nutshell114514/TU-Smart2026/(list of files, drawings)

Other design files:
硬件/21届智能车+蚂蚁搬家+主驱一体PCB文件.epro
