nutshell114514/TU-Smart2026/软件/比赛代码/下位机/config.py

# 整车任务的集中配置。除车辆身份外，主从车应使用相同参数。


# =============================================================================
# 车辆身份与位姿
# =============================================================================

# 1 = 主车，0 = 从车。build.bat 会为主从车生成对应配置。
_IS_LEADER = 1

# 上电时写入底层里程计的初始位置，单位为 cm；主从初始航向已固定在 base.py。
_LEADER_INIT_POS = (40.0, -40.0)
_FOLLOWER_INIT_POS = (10.0, -40.0)

# DONE 状态中主车、从车各自返回的世界坐标目标点，单位为 cm。
_DONE_TARGET_POS = (
    (25.0, -70.0),  # 主车
    (25.0, -70.0),  # 从车
)


# =============================================================================
# 搬运任务数量
# =============================================================================

# 1 = 只知道物体总数，使用 _OBJ_UNKNOWN_TOTAL，不限制各类别出现次数。
# 2 = 已知类别组数量，使用 _OBJ_GROUPS / _OBJ_GROUP_TOTAL；同组颜色二选一。
# 3 = 已知五类物体各自数量，使用 _OBJ_CLASS_TOTAL；每一类必须分别完成，不能互相替代。
_OBJ_COUNT_MODE = 3

# 模式 3：五类物体各自需要成功推出的数量。
# 第 0 项保留不用；1=网球，2=蓝沙包，3=红沙包，4=白熊，5=棕熊。
# 数量为 0 的类别不会被选择；只有五类剩余数量全部归零才结束任务。
_OBJ_CLASS_TOTAL = (0, 1, 1, 0, 1, 0)

# 模式 2：类别组成员与每组需要完成的数量。
# 当前任务固定为网球、任一颜色沙包、任一颜色熊各 1 个，共 3 个目标。
_OBJ_GROUPS = (
    (1,),    # 网球
    (2, 3),  # 蓝沙包、红沙包二选一
    (4, 5),  # 白熊、棕熊二选一
)
# 每一个组的目标数量，索引与 _OBJ_GROUPS 对应。
_OBJ_GROUP_TOTAL = (1, 1, 0)

# 模式 1：全部可搬运物体的总数。
_OBJ_UNKNOWN_TOTAL = 3


# =============================================================================
# WAIT_READY 路线换阵列避障
# =============================================================================

# 0 = 关闭：不检查其他待搬物体是否挡路，双车就绪后直接进入正常 PUSH。
# 1 = 开启：挡路时先换阵列横向推开目标，再恢复阵列并正常 PUSH。
_READY_ROUTE_AVOID_ENABLE = 0


# =============================================================================
# SEARCH / PUSH 场边 cone、brick 布局过滤
# =============================================================================

# 0 = 关闭：保持旧逻辑，完全不知道场边布局，只相信视觉识别结果。
# 1 = 开启：只有布局表允许的 cone/brick 才能触发 SEARCH 或 PUSH 障碍逻辑。
_OBSTACLE_LAYOUT_FILTER_ENABLE = 1

# 物体编号：0 = 没有，1 = cone，2 = brick。
# 每条边填 3 个位置；同一个位置只能填一个编号。
# 边顺序固定为 1、2、3、4，对应关系见 task_leader.py 的 _OBJ_PUSH_EDGE：
#   边1（高 Y，网球边）按 X 从小到大；边2（低 X，沙包边）按 Y 从小到大；
#   边3（高 X，熊边）按 Y 从小到大；边4（低 Y，无固定推送目标的边）按 X 从小到大。
# 目前先全部留空；填好现场布局后，再把上面的总开关改成 1。
_OBSTACLE_EDGE_LAYOUT = (
    (0, 0, 0),  # 边1（网球边）：X 小、中、大
    (0, 0, 2),  # 边2（沙包边）：Y 小、中、大
    (0, 0, 0),  # 边3（熊边）：Y 小、中、大
    (0, 0, 0),  # 边4（无固定推送目标）：X 小、中、大
)

# SEARCH 中把误识别成红沙包的固定砖过滤掉：砖区域从对应场地边界线向
# 两侧取 50 cm；沿边方向使用上表的三等分区间，并在区间两端各扩展 20 cm，
# 让相邻区域存在重叠，避免世界坐标抖动刚好越过三等分边界时漏检。
_RED_SANDBAG_BRICK_ZONE_EDGE_DEPTH_CM = 60.0
_RED_SANDBAG_BRICK_ZONE_ALONG_TOL_CM = 20.0

# 四个角点从发车区 (0, 0) 开始顺时针填写：
#   角0=(0,0)，角1=(0,Ymax)，角2=(Xmax,Ymax)，角3=(Xmax,0)。
# 角点物体同时归属于与它相邻的两条边。
_OBSTACLE_CORNER_LAYOUT = (0, 0, 0, 0)


# =============================================================================
# SEARCH
# =============================================================================

# 首次 SEARCH 航向模式：0 = 90° 搜索，1 = 0° 搜索。
# 只影响首次固定斜移结束后的转向、编队和横扫；车辆初始化、BOOT 横移以及
# 首次固定斜移本身仍保持 90°。后续 SEARCH 使用上一次推出方向的反方向。
_SEARCH_INITIAL_YAW_MODE = 0

# 主车从进入 SEARCH 开始计时的超时阈值，单位为 ms。
_SEARCH_TIMEOUT_MS = 20000
