nutshell114514/TU-Smart2026/(commit log)

2026-08-26 代码更新
2026-08-26 主驱一体板硬件设计
    [21届智能车+蚂蚁搬家+主驱一体PCB文件.epro]
